jakabo27/ESPHome-Craftmade-RF-Gateway/media/hardware/Module Pinout.jpg

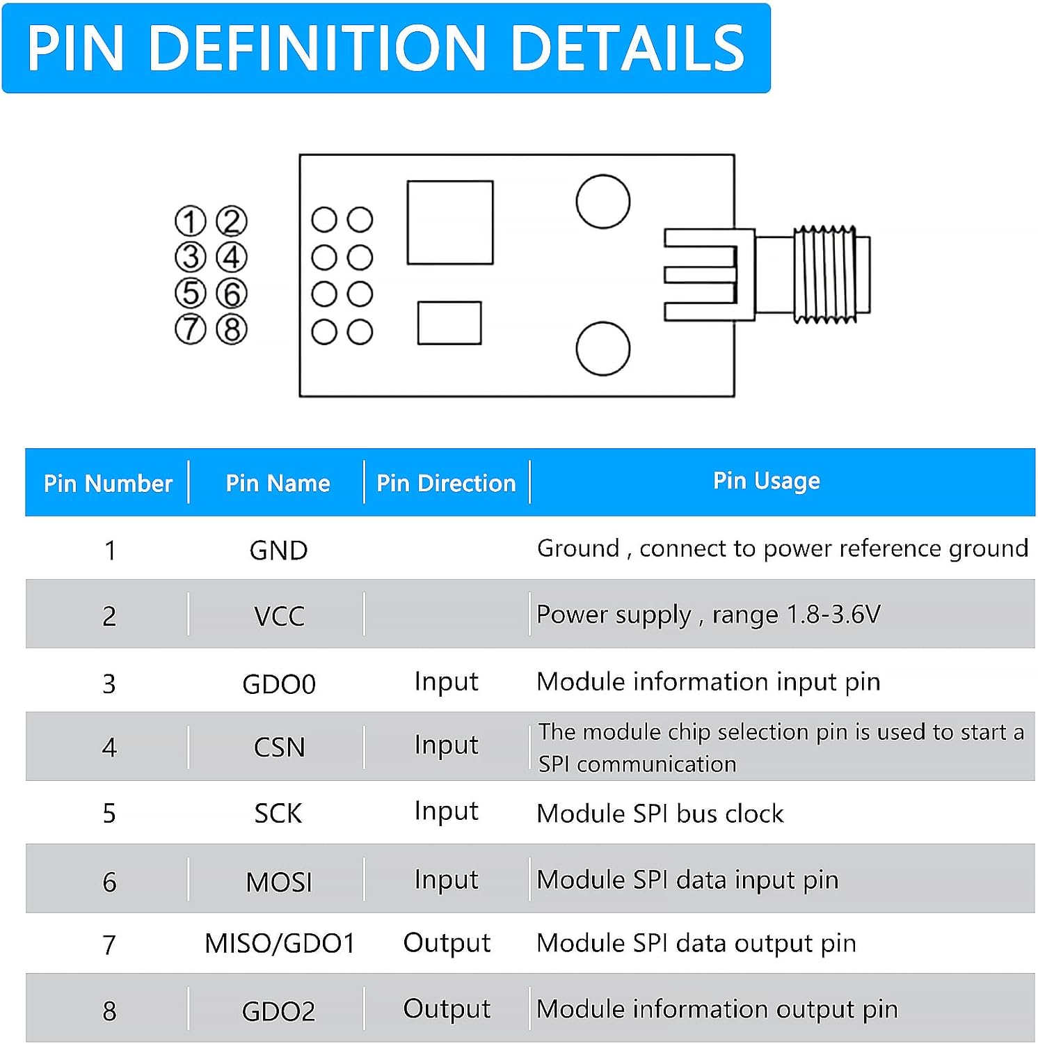
media/hardware/Module Pinout.jpg
