jakabo27/ESPHome-Craftmade-RF-Gateway/enclosure/RF-Box-Main.stl

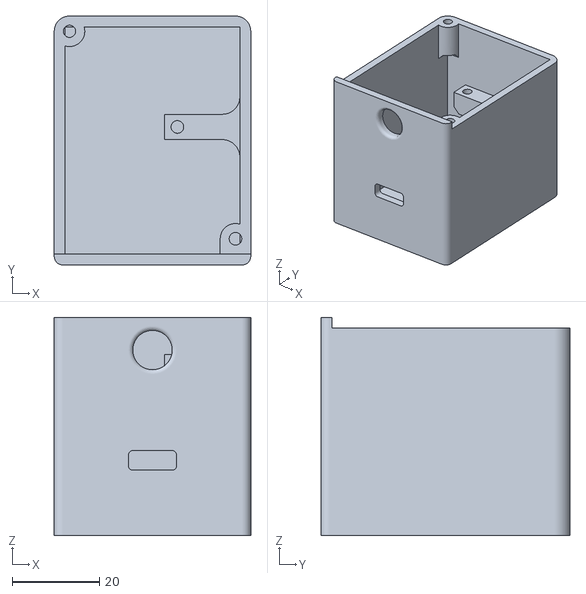
[picture p7: CAD file, 2026-10-11]
enclosure/RF-Box-Main.stl
45.0 x 57.0 x 50.0
