jakabo27/ESPHome-Craftmade-RF-Gateway/enclosure/RF-Box-Lid.stl

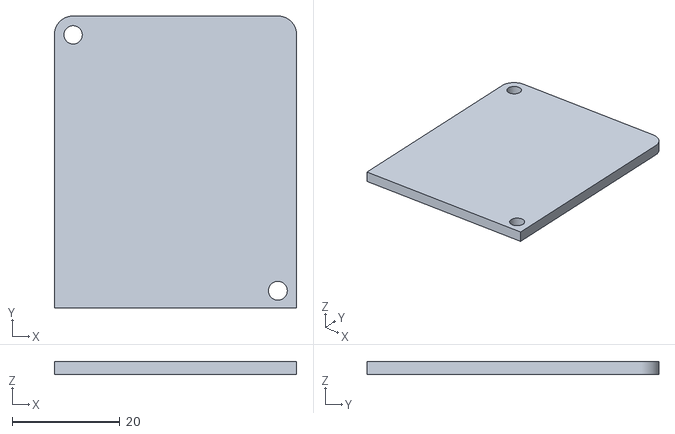
[picture p8: CAD file, 2026-10-11]
enclosure/RF-Box-Lid.stl
45.0 x 54.2 x 2.50
