jakabo27/ESPHome-Craftmade-RF-Gateway/media/hardware/setup-enclosure-placeholder.png

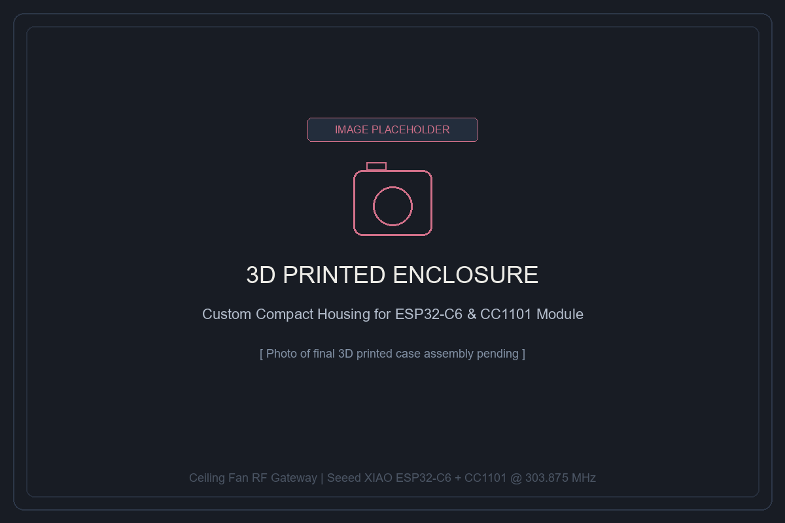
media/hardware/setup-enclosure-placeholder.png
