jakabo27/ESPHome-Craftmade-RF-Gateway/(commit log)

2026-09-30 Initial release: ESPHome Craftmade Ceiling Fan & Light RF Gateway with reverse-engineered 303.875 MHz protocol, low-power standby, and Home Assistant integration
2026-09-30 Refine diagrams and media: simplify architecture flowchart, fix overlapping fonts in wiring schematic, and square-scale wall remote image
2026-09-30 Streamline README: remove ASCII art and place Photos & Prototypes directly between Architecture Overview and Key Highlights
2026-09-30 Fix wiring diagram XML parsing error, remove glow effect from RF timing trace, and expand command bracket box
2026-09-30 Remove glow filter from wiring diagrams and update README link to wiring-schematic.svg to clear cached client error
2026-10-10 Add RF remote press sync, safe light handling, and final enclosure photo
    - Listen for the original remote with the CC1101 receiver and mirror fan
    Low/Medium/High/Off and light toggles into Home Assistant without
    transmitting anything back (rx_sync guard).
    - Classify received pulses as short/long instead of matching exact timings,
    since the receive path measures different absolute widths than transmit.
    - Track believed light state so a redundant "off" never toggles the bulb on;
    add a "Light State Flip (no RF)" resync button.
    - Stay silent on boot while state is restored.
    - Turn Wi-Fi power save off (modem sleep caused multi-hour dropouts) and add
    diagnostic sensors (uptime, signal,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
2026-10-10 Replace prototype placeholder with photo of the working breadboard build
2026-10-10 Fix overlapping text in timing and wiring diagrams
    - Timing: move title block up so the subtitle no longer collides with the
    FIXED ADDRESS / COMMAND labels; separate the T and 2T caliper labels.
    - Wiring: centre the CC1101 silk text inside the module, move the 2x4 PIN
    HEADER caption below the pin rows, move the D6 label clear of the wires,
    and pull the table columns left so the notes column is no longer cut off.
    - Update the GDO2 note to mention remote press sync.
2026-10-10 Add Home Assistant device page screenshot to README
    IP address, BSSID and MAC are blanked out.
2026-10-11 Add 3D-printable enclosure STL files (main body and lid)
