jakabo27/ESPHome-Craftmade-RF-Gateway/(notices)

Notices in the files:
README.md:
License: MIT
